AdilAry/Embed_System_Project/Software/Unsorted_Material/Embed_System_Project-main/Hardware/MISC/pcb back.jpeg

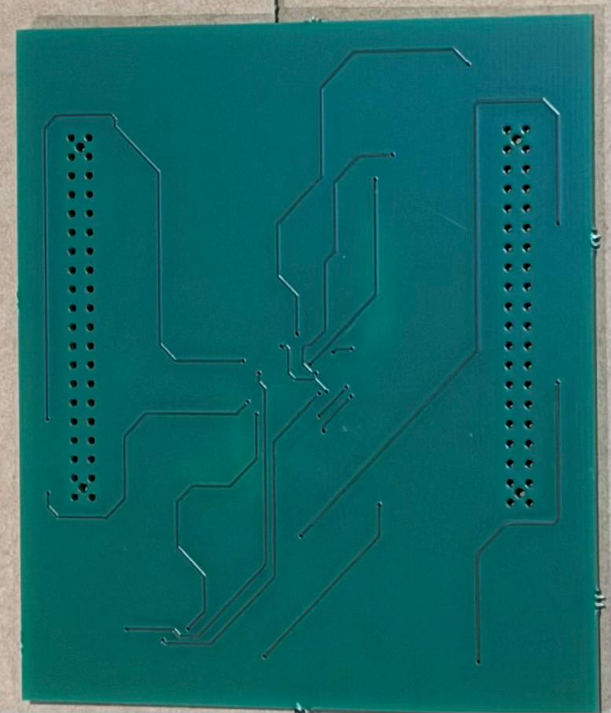
Software/Unsorted_Material/Embed_System_Project-main/Hardware/MISC/pcb back.jpeg
