AdilAry/Embed_System_Project/Software/Unsorted_Material/Embed_System_Project-main/Hardware/MISC/pcb front.jpeg

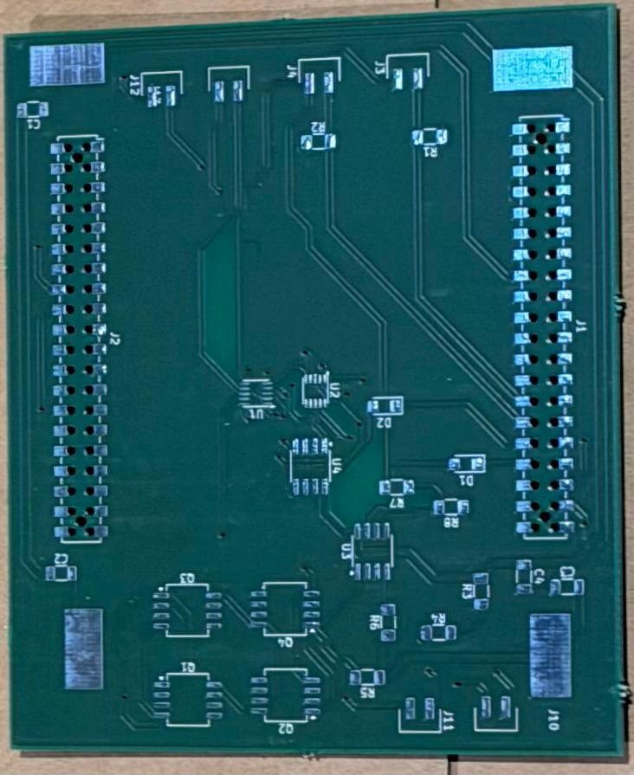
Software/Unsorted_Material/Embed_System_Project-main/Hardware/MISC/pcb front.jpeg
