AdilAry/Embed_System_Project/Software/Unsorted_Material/Embed_System_Project-main/Hardware/MISC/Info_Dump/BMS ICs.md

---
created: 2025.09.30 8:55 AM Tuesday
tags: red
---
https://www.ti.com/product-category/battery-management-ics/overview.html
