AdilAry/Embed_System_Project/Software/Unsorted_Material/Embed_System_Project-main/Hardware/MISC/Info_Dump/MOSFET.md

---
created: 2025.09.24 9:18 AM Wednesday
tags: red
---
https://www.youtube.com/results?search_query=mosfets+
https://www.mokoenergy.com/bms-mosfet/

https://diysolarforum.com/threads/bms-mosfets-explained.29318/
https://www.upnorthandpersonal.net/?page_id=112

https://www.aosmd.com/sites/default/files/res/application_notes/mosfets/MOS-013.pdf
