AdilAry/Embed_System_Project/Software/Unsorted_Material/Embed_System_Project-main/Hardware/2.LTspice/4.Diagram/Like_This_(example)/0.Explanations.md

Component_1 -> Analog signal processing.
Component_2 -> Transmitter.
Component_3 -> Powersupply.

---
### Diagram.

Transformer -> Power supply -> 
-> Analog signal processing -> Transmitter.
