AdilAry/Embed_System_Project/Software/Unsorted_Material/Embed_System_Project-main/Hardware/4.Documentation/English_Course.docx

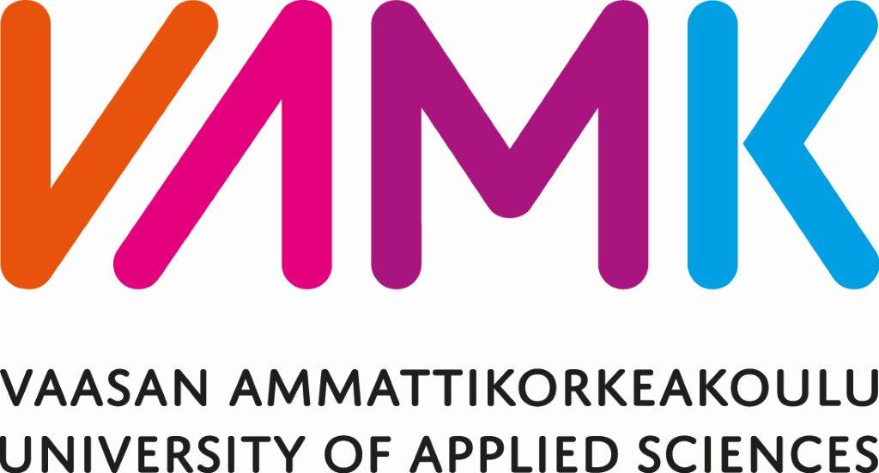
[picture p10: figure]
VAMK Vaasan ammattikorkeakoulu, University of Applied Sciences.

battery Management System

Progress report

Embedded Systems Project

2025

CONTENTS

# 1 Introduction

This report is focused on providing the team’s progress on making the Battery Management System project.

## 1.1 Battery Management System

Battery Management System, or BMS for short, is a system that, at its very basic, protects a battery or batteries from different electrical hazards like short circuits, cell overcharge, and overcurrent, as well as providing valuable information on the connected device; Voltage, current, and temperature measurements.

## 1.2 Progress

So far we have compiled a number of source for the research and learning purposes, as well as made many different drafts and partially implemented them in Ltspice. Unfortunatly, due to strict deadlines in place as per the time needed for the manufacturing and ordering of Printed Circuit Boards.

# 2 Project plans

## 2.1 Schematic and Printed Circuit Board

As mentioned before a strict schedule puts limitations on what the team can accomplish, instead focusing on finishing the simulations a hard decision to pivot straight into the designing the PCB was made.

## 2.2 Component choice

After the PCB is complete and is ready to be ordered, will be the time to order the component used to build the final project.
