AdilAry/Embed_System_Project/Software/Unsorted_Material/Embed_System_Project-main/Hardware/2.LTspice/4.Diagram/Like_This_(example)/Diagram_The_Transformer_breaks_the_PC_so_its_not_there.png

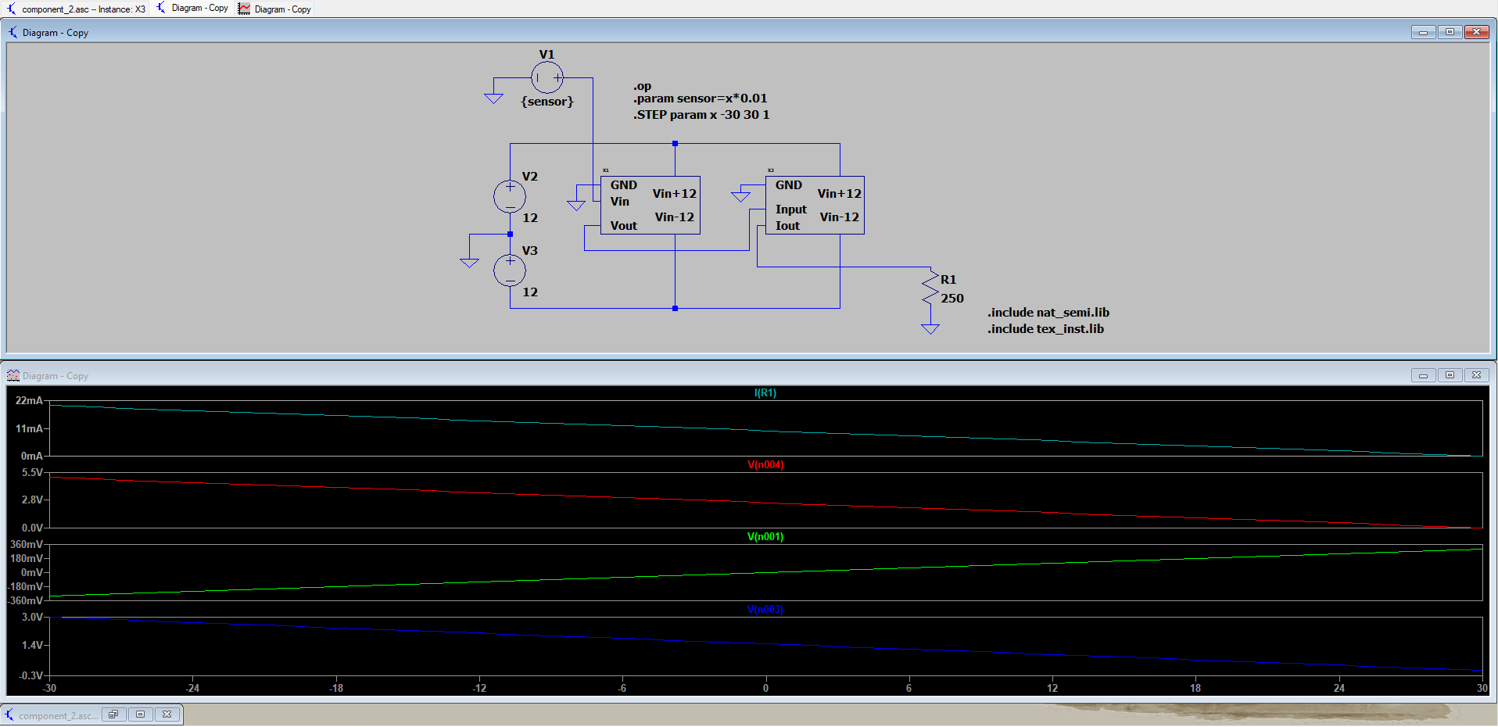
Software/Unsorted_Material/Embed_System_Project-main/Hardware/2.LTspice/4.Diagram/Like_This_(example)/Diagram_The_Transformer_breaks_the_PC_so_its_not_there.png
