AdilAry/Embed_System_Project/Software/Unsorted_Material/Embed_System_Project-main/Hardware/2.LTspice/4.Diagram/Like_This_(example)/Screenshot 2025-09-22 090422.png

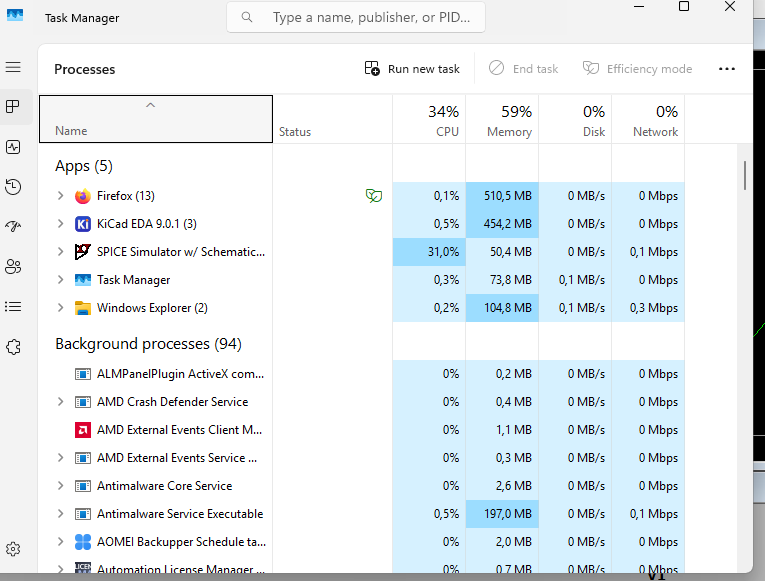
Software/Unsorted_Material/Embed_System_Project-main/Hardware/2.LTspice/4.Diagram/Like_This_(example)/Screenshot 2025-09-22 090422.png
