AdilAry/Embed_System_Project/Software/Presentation_Material/Communications_Documentation.odt

VAMK Vaasan ammattikorkeakoulu, University of Applied Sciences.

Communications

Documentation

Embedded Systems Programming 2025

CONTENTS

# Introduction

This document is aimed at providing all the necessary information and details regarding the BMS communications, for the purposes of making the Software team’s life easier.

The document will contain, the communication standard, protocol, used STM pins and what kind of data the software side should receive and how that data should be interpreted.

## Software introduction;

The software part overall can be seperated into three:

- On a board, to collect, communicate/send three data points(current, temperature and individual cell voltages of a battery) and also act upon those data points(drive the MOSFET switch, Control MUX adress line switches).

- On a computer, to visualize those three data points as a readable graph.

- On a database, to store a log of the mentioned three data points across a timeline.

## Communications choices;

The choice of a communications protocol fell into Modbus where the BMS will be the slave node and PC will function as the master node. The communication will be done through cable with the RS-485 standard.

# Specifications

## Board controll;

The board shouldn’t just collect and send the data, but also act upon.

PC0 – For charge control.

PC1 – For discharge control.

And the output from those into the MOSFET should be higher than 600 mV to ensure that their gates can open.

PC2, PC3 – For A0 and A1 line controll switches of the Multiplexers.

## Input from Board;

PA4 – Takes in voltage measurements of a single battery cell.

PB1 – Takes in current measurements.

PA0, PA1 – Taking in temperature measurements.

## Expected Behaviour;

Regularly switch between individual battery cells for voltage measurement via PC2 and PC3, whenever any single out of the four cells has a voltage measurement below 2.5V or above 3.65V initiate discharge.

Whenever any of the two thermistors records temperatures below -20 C or above 40 C initiate discharge.
