AdilAry/Embed_System_Project/Software/Unsorted_Material/Embed_System_Project-main/Hardware/3.Budgeting/BOM.xlsx

Mouser No. | Mfr. No. | Quantity
737-RS2BE-20-G-SMT | RS2BE-20-G-SMT | 2 | 2x20 conn
504-NRBE104J3435B2J | NRBE104J3435B2J | 2 |  | Thermistor
708-RNCE0805BTE10K0 | RNCE0805BTE10K0 | 6 | 10KO resistor
781-SI4116DY-E3 | SI4116DY-T1-E3 | 4 |  | NMOS
595-TMUX1204DQAR | TMUX1204DQAR | 2 | Multiplexer
78-MMSZ4683-HE3_A-08 | MMSZ4683-HE3_A-08 | 2 |  | Zener 3
437-8018700240002101 | 801-87-002-40-002101 | 2 | 1x2 conn female
80-C0805F104K1RAUTO | C0805F104K1RACAUTO | 2 |  | 100nF Capacitor
595-INA826AIDR | INA826AIDR | 2 | Instrumentation Amplifier
667-ERJ-UP6D1600V | ERJ-UP6D1600V | 1 |  | 160 Resistor
603-PU2512FKNP50R01L | PU2512FKNP50R001L | 1 | 1m Shunt
649-1012938090202ALF | 10129380-902002ALF | 2 |  | 1x2 conn male
