AdilAry/Embed_System_Project/Software/Unsorted_Material/Embed_System_Project-main/Hardware/3.Budgeting/Manufacturer.md

https://aisler.net/

Based in Germany, ~10 days delivery, Accepts KiCAD files.
