AdilAry/Embed_System_Project/Software/Unsorted_Material/Embed_System_Project-main/Hardware/4.Documentation/Soldering and manufacturer documentation.odt

Embedded System Project

Documentation

Parts : Manufacturer, delivered product, soldering

Manufacturer

Manufacturer part was a fun and decision making part of the project we looked into several manufacturers and while doing that we were given some criteria to select the manufacturer. Those criteria were, European manufacturer, do not pay shipping cost, price shouldn’t be too expensive. Well these gave us some hard time because most cheap manufacturers were from china and other Asian parts of the world, some European manufacturer do it for cheaper price but their shipping was too long , in the end we selected Aisler , they gave us the quote for 35€ for three PCB so we selected it .

Issues: the shipping took too long than we expected and we didn’t choose tracking so we got some post retransfer issues.

Delivered Product:

Delivery of the product was nice and clean, it was exactly what we expected but then we found out the traces we made was smaller for some components but that’s other part issues will be covered there.

Soldering.

This was my favorite part of this project, while soldering we were able to solder many components easily using the air gun using the hot air gun was pretty new and we had to learn some technics on how not to burn some components, when it came to some components like mosfets and the shunt resistor the traces were too small .

Issues: traces were too small for mosfets and the shunt resistor, burnt the temperature sensor.

Fix: we couldn’t do anything for the mosfets but we attached extra wires to the shunt resistor and made it work , for the burnt temperature sensor luckily we had 2 so we used the other one, so now we learnt a lesson to double check and be more careful to create traces which can be actually soldered to the components.
