AdilAry/Embed_System_Project/Software/Unsorted_Material/Embed_System_Project-main/Hardware/MISC/Problem_1/Explanations_Screenshot.png

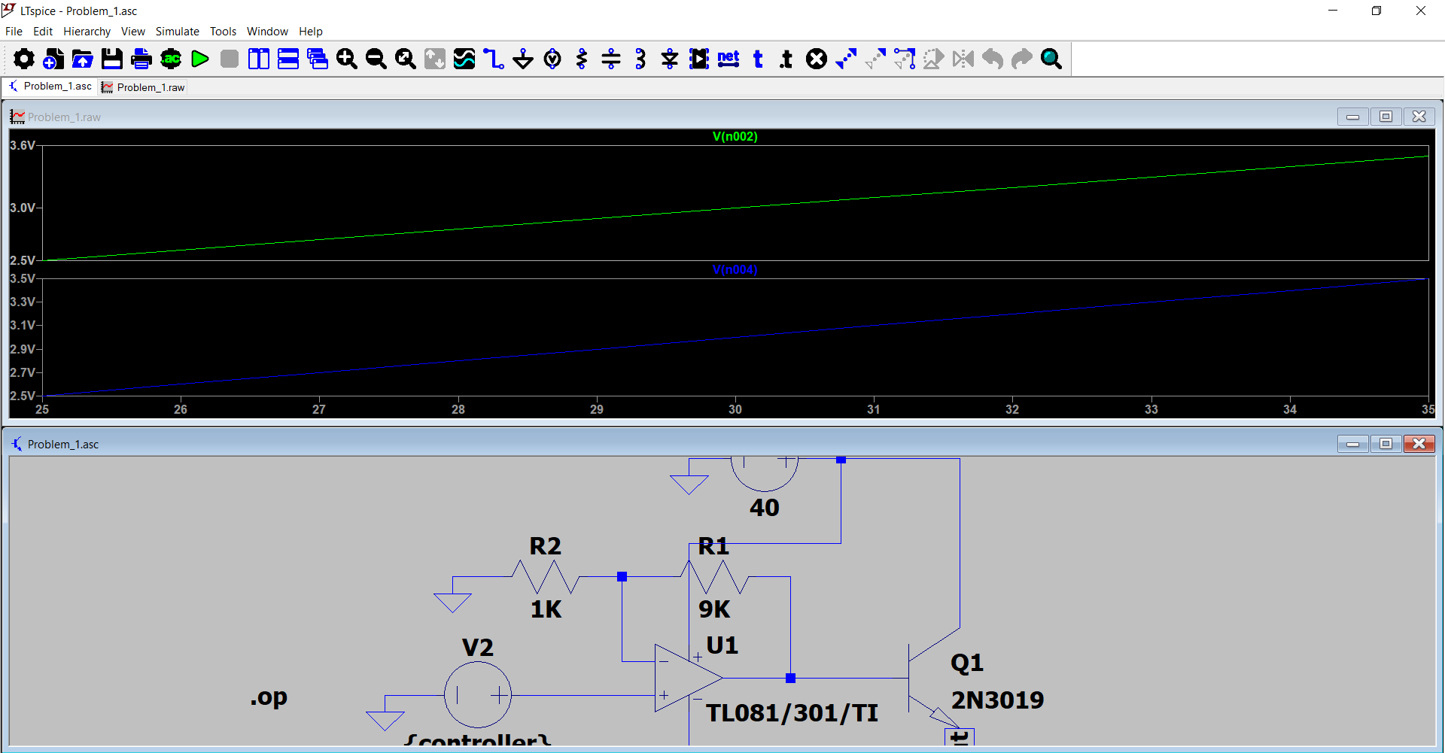
Software/Unsorted_Material/Embed_System_Project-main/Hardware/MISC/Problem_1/Explanations_Screenshot.png
