AdilAry/Embed_System_Project/Software/Unsorted_Material/Embed_System_Project-main/Hardware/MISC/Problem_1/Screenshot (424).png

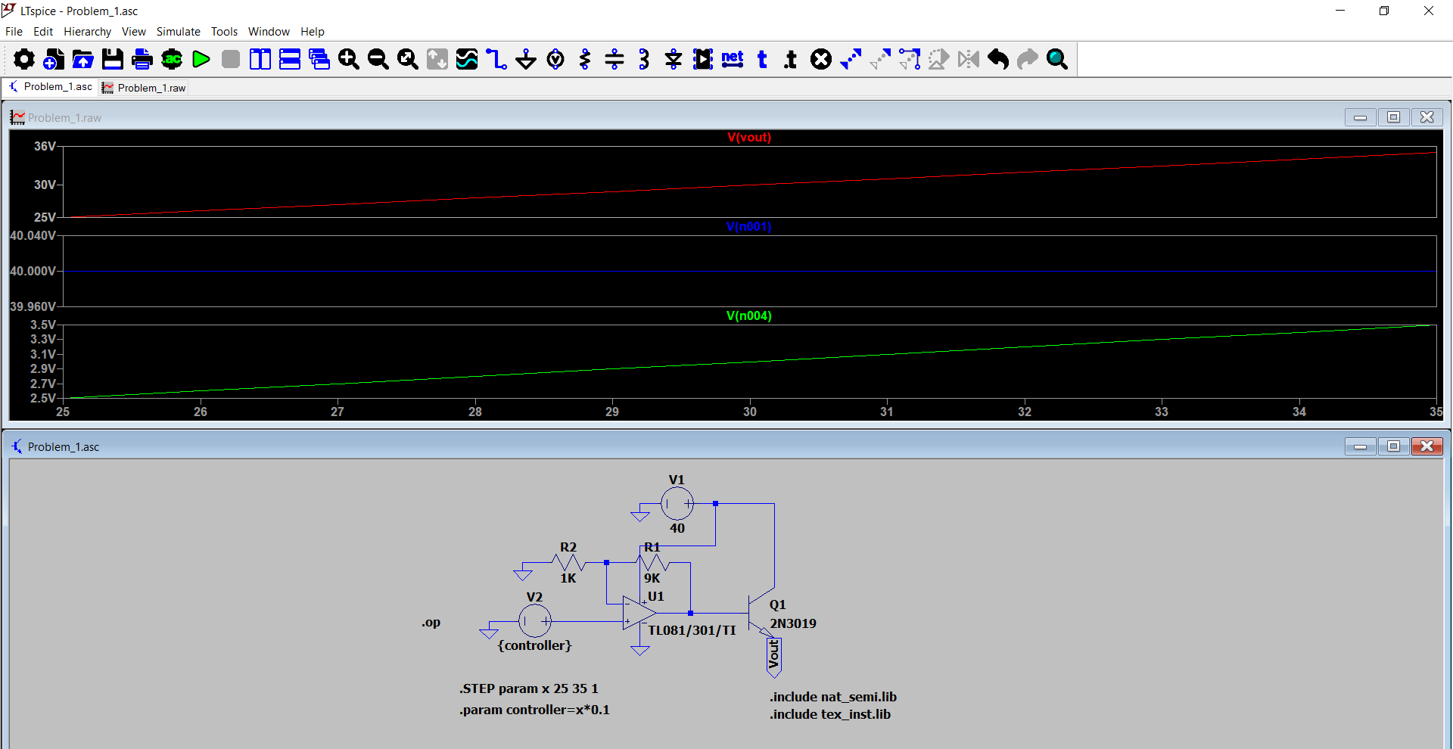
Software/Unsorted_Material/Embed_System_Project-main/Hardware/MISC/Problem_1/Screenshot (424).png
