AdilAry/Embed_System_Project/Software/Unsorted_Material/Embed_System_Project-main/Hardware/MISC/Problem_1/LTspice/Problem_1.asc

Q1: npn; 2N3019
R1: res; 9K
R2: res; 1K
U1: opamp2; TL081/301/TI
V1: voltage; 40
V2: voltage; {controller}
Named nets: 0, Vout
.STEP param x 25 35 1
.param controller=x*0.1
.op
.include nat_semi.lib
.include tex_inst.lib
