AdilAry/Embed_System_Project/Software/Unsorted_Material/Embed_System_Project-main/Hardware/2.LTspice/1.Swtich_Drafts/Draft.asc

D1: LED
D2: LED
M1: nmos
M2: nmos
R1: res
V1: voltage
V2: voltage
V3: voltage
V4: voltage
V5: voltage; {c_control}
V6: voltage; {d_control}
Named nets: Vout, 0
.include nat_semi.lib
.include tex_inst.lib
