AdilAry/Embed_System_Project/Software/Unsorted_Material/Embed_System_Project-main/Hardware/2.LTspice/2.Current_Measurement_Drafts/Draft.asc

D1: zener
R1: res
R2: res
R3: res
U1: opamp2
V1: voltage; 3
V2: voltage; 3
V3: voltage; 3
V4: voltage; 3
Named nets: 0, Vout, Imaginary_Fuse
.include nat_semi.lib
.include tex_inst.lib
