AdilAry/Embed_System_Project/Software/Unsorted_Material/Embed_System_Project-main/Hardware/2.LTspice/3.Voltage_Measurement_Drafts/Draft.asc

D2: zener
R1: res
R2: res
U1: opamp2
V1: voltage; {x}
V5: voltage; 15
Named nets: Vout, 0
.include nat_semi.lib
.include tex_inst.lib
