AdilAry/Embed_System_Project/Software/Unsorted_Material/Embed_System_Project-main/Hardware/2.LTspice/3.Voltage_Measurement_Drafts/Draft_full.asc

R1: res
R2: res
R3: res
R4: res
R5: res
R6: res
R7: res
R8: res
U1: opamp2
U2: opamp2
U3: opamp2
U4: opamp2
V1: voltage; 1
V2: voltage; 2
V3: voltage; 3
V4: voltage; 4
V5: voltage; 15
Named nets: 0, Vout
.include nat_semi.lib
.include tex_inst.lib
