AdilAry/Embed_System_Project/Software/Unsorted_Material/Embed_System_Project-main/Hardware/MISC/Problem_1/Component_3.asc

C1: cap; 600µ
C2: cap; 100n
C3: cap; 600µ
C4: cap; 100n
C5: cap; 100n
C6: cap; 1000µ
C7: cap; 100n
C8: cap; 1000µ
D1: diode; 1N4148
D2: diode; 1N4148
D3: diode; 1N4148
D4: diode; 1N4148
L1: ind2; 3000
L2: ind2; 32
L3: ind2; 3000
L4: ind2; 32
R1: res; 1
R2: res; 1
R3: res; 470
R4: res; 4042
R5: res; 470
R6: res; 4042
U1: LM317
U2: LM337
V1: voltage; SINE(0 230 50 0 0 0 1e6)
Named nets: Vout-, Vout+, GND
.include nat_semi.lib
.include tex_inst.lib
K1 L1 L2 1
K2 L3 L4 1
