AdilAry/Embed_System_Project/Software/Unsorted_Material/Embed_System_Project-main/Hardware/2.LTspice/4.Diagram/Like_This_(example)/Component_1.asc

R2: res; 10K
R3: res; 256.4
R4: res; 10K
R5: res; 10K
R6: res; 50K
R7: res; 50K
U1: opamp2; TL071/301/TI
U2: opamp2; TL071/301/TI
U3: opamp2; TL071/301/TI
Named nets: Vin-12, Vin+12, GND, Vout, Vin
.include nat_semi.lib
.include tex_inst.lib
