AdilAry/Embed_System_Project/Software/Unsorted_Material/Embed_System_Project-main/Hardware/2.LTspice/4.Diagram/Like_This_(example)/Component_2.asc

C1: cap; 100n
Q1: npn; BC547B
R1: res; 150
R3: res; 100
R4: res; 150K
R5: res; 150K
R6: res; 150K
R7: res; 150K
U1: opamp2; LM741/NS
Named nets: Iout, Vin+12, Vin-12, Input, GND
.include nat_semi.lib
.include tex_inst.lib
