AdilAry/Embed_System_Project/Software/Unsorted_Material/Embed_System_Project-main/Hardware/2.LTspice/4.Diagram/Like_This_(example)/Diagram - Copy.asc

R1: res; 250
V1: voltage; {sensor}
V2: voltage; 12
V3: voltage; 12
X1: Component_1
X3: Component_2
Named nets: 0
.include nat_semi.lib
.include tex_inst.lib
.STEP param x -30 30 1
.op
.param sensor=x*0.01
