AdilAry/Embed_System_Project/Software/Unsorted_Material/Embed_System_Project-main/Hardware/2.LTspice/4.Diagram/Like_This_(example)/Diagram_with_Transformer.asc

V1: voltage; {x}
X1: Component_1
X2: Component_3
X3: Component_2
Named nets: 0
.include nat_semi.lib
.include tex_inst.lib
.tran 0 200m 0 1m
.STEP param x -0.3 0.3 0.01
