AdilAry/Embed_System_Project/Software/Unsorted_Material/Embed_System_Project-main/Hardware/MISC/Problem_1/LTspice/Experimenting.asc

U1: opamp2
V2: voltage; 12
V3: voltage; 12
V4: voltage; {x}
Named nets: VCC, VEE, 0, out
.op
.include nat_semi.lib
.param
