AdilAry/Embed_System_Project/Software/Unsorted_Material/Embed_System_Project-main/Hardware/1.KiCAD/KiCAD.kicad_pcb

## KiCad design Software/Unsorted_Material/Embed_System_Project-main/Hardware/1.KiCAD/KiCAD.kicad_pcb (2025-10-10)

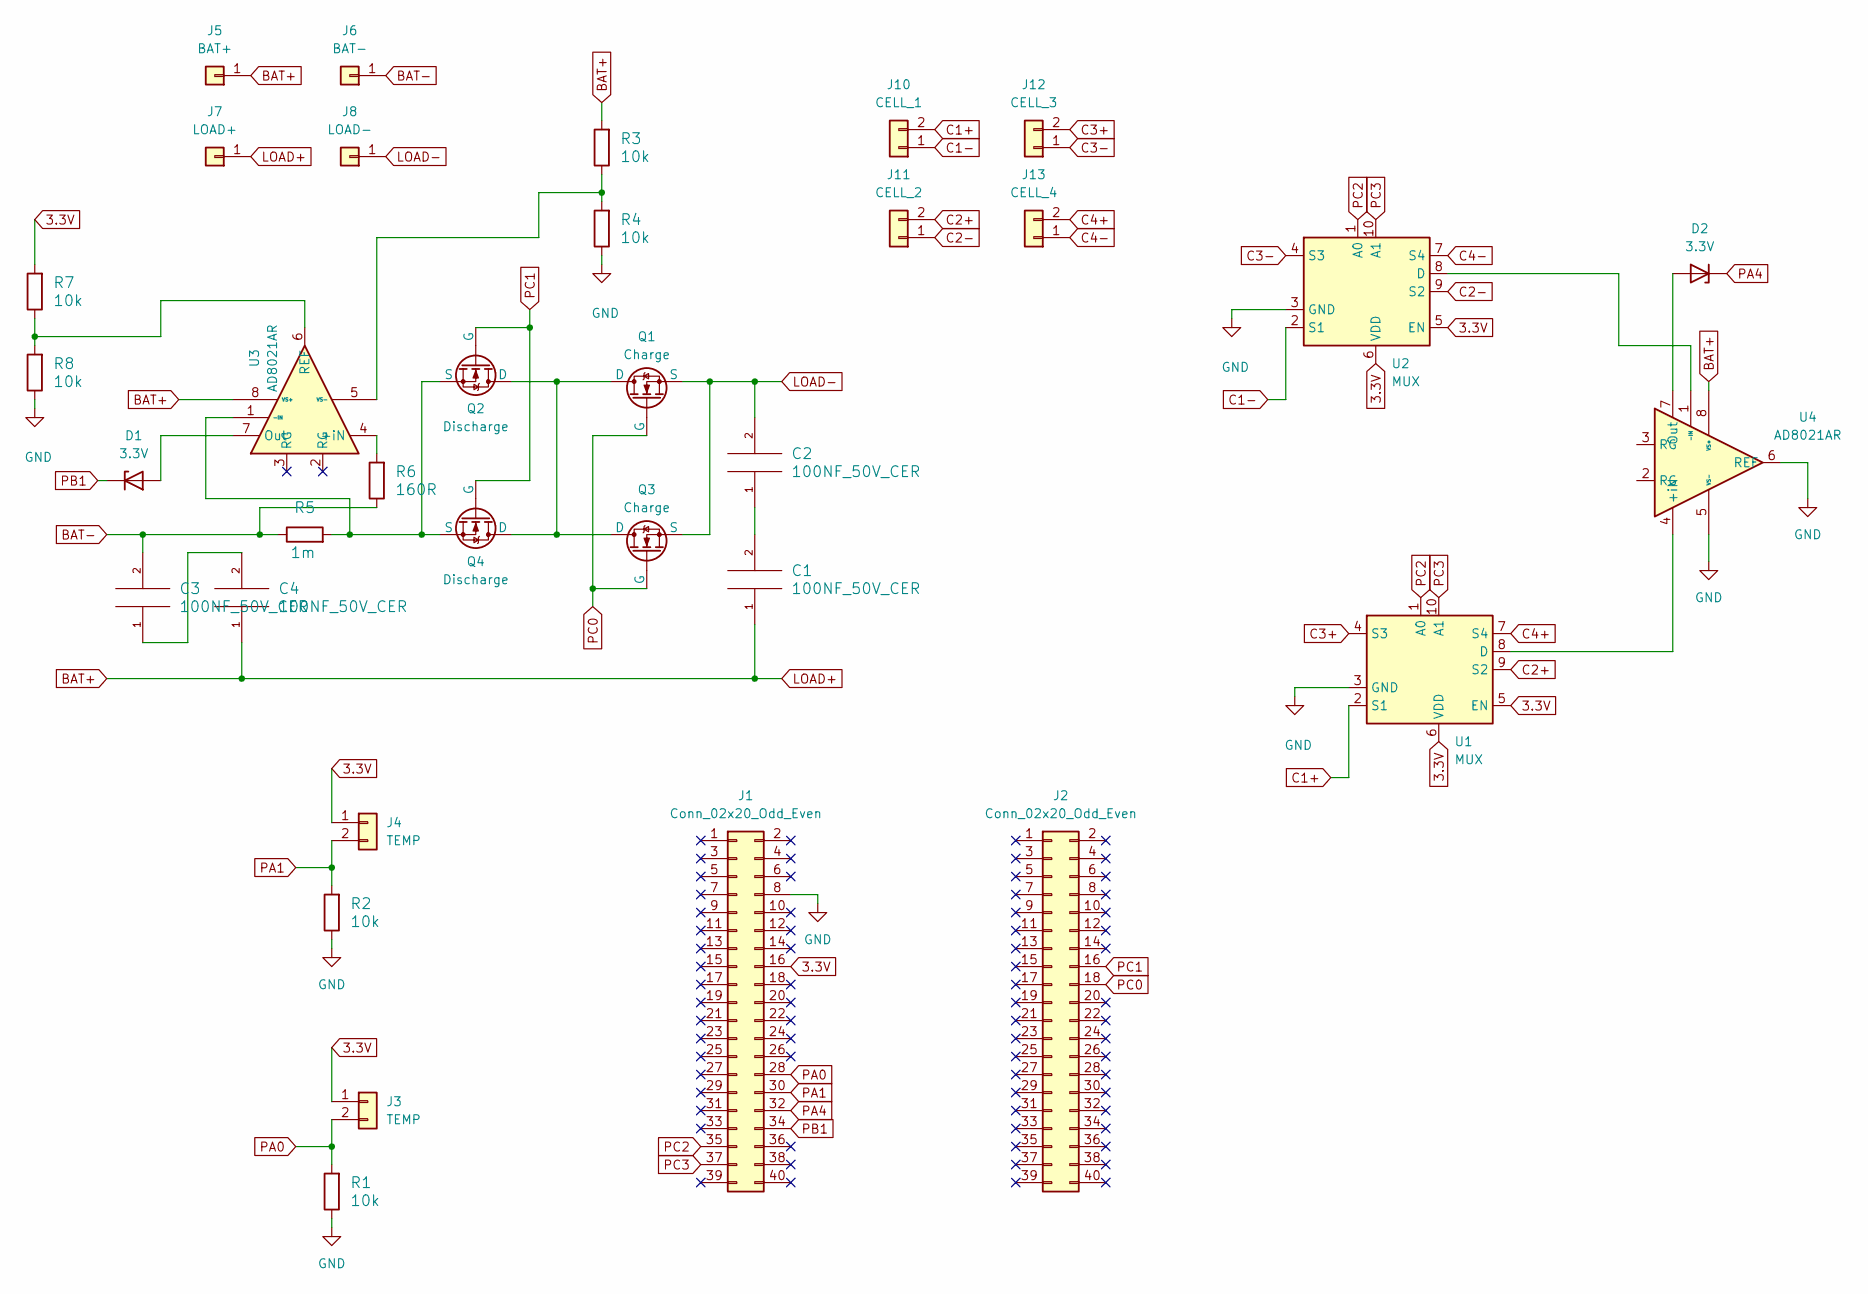
[picture p15: schematic KiCAD.kicad_sch]

Parts:
C1, C2, C3, C4: 100NF_50V_CER; C1206; Tolerance +-10%
D1, D2: 3.3V; D_SMF
J1, J2: Conn_02x20_Odd_Even; Samtec_HLE-120-02-xxx-DV-BE-LC_2x20_P2.54mm_Horizontal
J3, J4: TEMP; PinHeader_1x02_P2.54mm_Vertical_SMD_Pin1Left
J5: BAT+; SolderWirePad_1x01_SMD_5x10mm
J6: BAT-; SolderWirePad_1x01_SMD_5x10mm
J7: LOAD+; SolderWirePad_1x01_SMD_5x10mm
J8: LOAD-; SolderWirePad_1x01_SMD_5x10mm
J10: CELL_1; PinHeader_1x02_P2.54mm_Vertical_SMD_Pin1Left
J11: CELL_2; PinHeader_1x02_P2.54mm_Vertical_SMD_Pin1Left
J12: CELL_3; PinHeader_1x02_P2.54mm_Vertical_SMD_Pin1Left
J13: CELL_4; PinHeader_1x02_P2.54mm_Vertical_SMD_Pin1Left
Q1, Q3: Charge; SOIC-8_5.3x6.2mm_P1.27mm
Q2, Q4: Discharge; SOIC-8_5.3x6.2mm_P1.27mm
R1, R2, R3, R4, R7, R8: 10k; 1206; Tolerance +-5%
R5: 1m; 1206; Tolerance +-5%
R6: 160R; 1206; Tolerance +-5%
U1, U2: MUX; TSSOP-10_3x3mm_P0.5mm
U3, U4: AD8021AR; SOIC-8_3.9x4.9mm_P1.27mm

Connections:
3.3V: J1.16, J3.1, J4.1, R7.2, U1.5 (EN), U1.6 (VDD), U2.5 (EN), U2.6 (VDD)
BAT+: C1.1, C4.1, J5.1, J7.1, R3.2, U3.8 (VS+), U4.8 (VS+)
BAT-: C3.2, J6.1, R5.1, R6.1
C1+: J10.2, U1.2 (S1)
C1-: J10.1, U2.2 (S1)
C2+: J11.2, U1.9 (S2)
C2-: J11.1, U2.9 (S2)
C3+: J12.2, U1.4 (S3)
C3-: J12.1, U2.4 (S3)
C4+: J13.2, U1.7 (S4)
C4-: J13.1, U2.7 (S4)
GND: J1.8, R1.1, R2.1, R4.1, R8.1, U1.3 (GND), U2.3 (GND), U4.5 (VS-), U4.6 (REF)
LOAD-: C2.2, J8.1, Q1.1 (S), Q3.1 (S)
unnamed: C1.2, C2.1
unnamed: C3.1, C4.2
unnamed: D1.2 (A), U3.7 (Out)
unnamed: D2.2 (A), U4.7 (Out)
unnamed: Q1.8 (D), Q2.8 (D), Q3.8 (D), Q4.8 (D)
unnamed: Q2.1 (S), Q4.1 (S), R5.2, U3.1 (-IN)
unnamed: U1.8 (D), U4.4 (+iN)
unnamed: U2.8 (D), U4.1 (-IN)
unnamed: R6.2, U3.4 (+iN)
unnamed: R7.1, R8.2, U3.6 (REF)
unnamed: R3.1, R4.2, U3.5 (VS-)
PA0: J1.28, J3.2, R1.2
PA1: J1.30, J4.2, R2.2
PA4: D2.1 (K), J1.32
PB1: D1.1 (K), J1.34
PC0: J2.18, Q1.4 (G), Q3.4 (G)
PC1: J2.16, Q2.4 (G), Q4.4 (G)
PC2: J1.35, U1.1 (A0), U2.1 (A0)
PC3: J1.37, U1.10 (A1), U2.10 (A1)

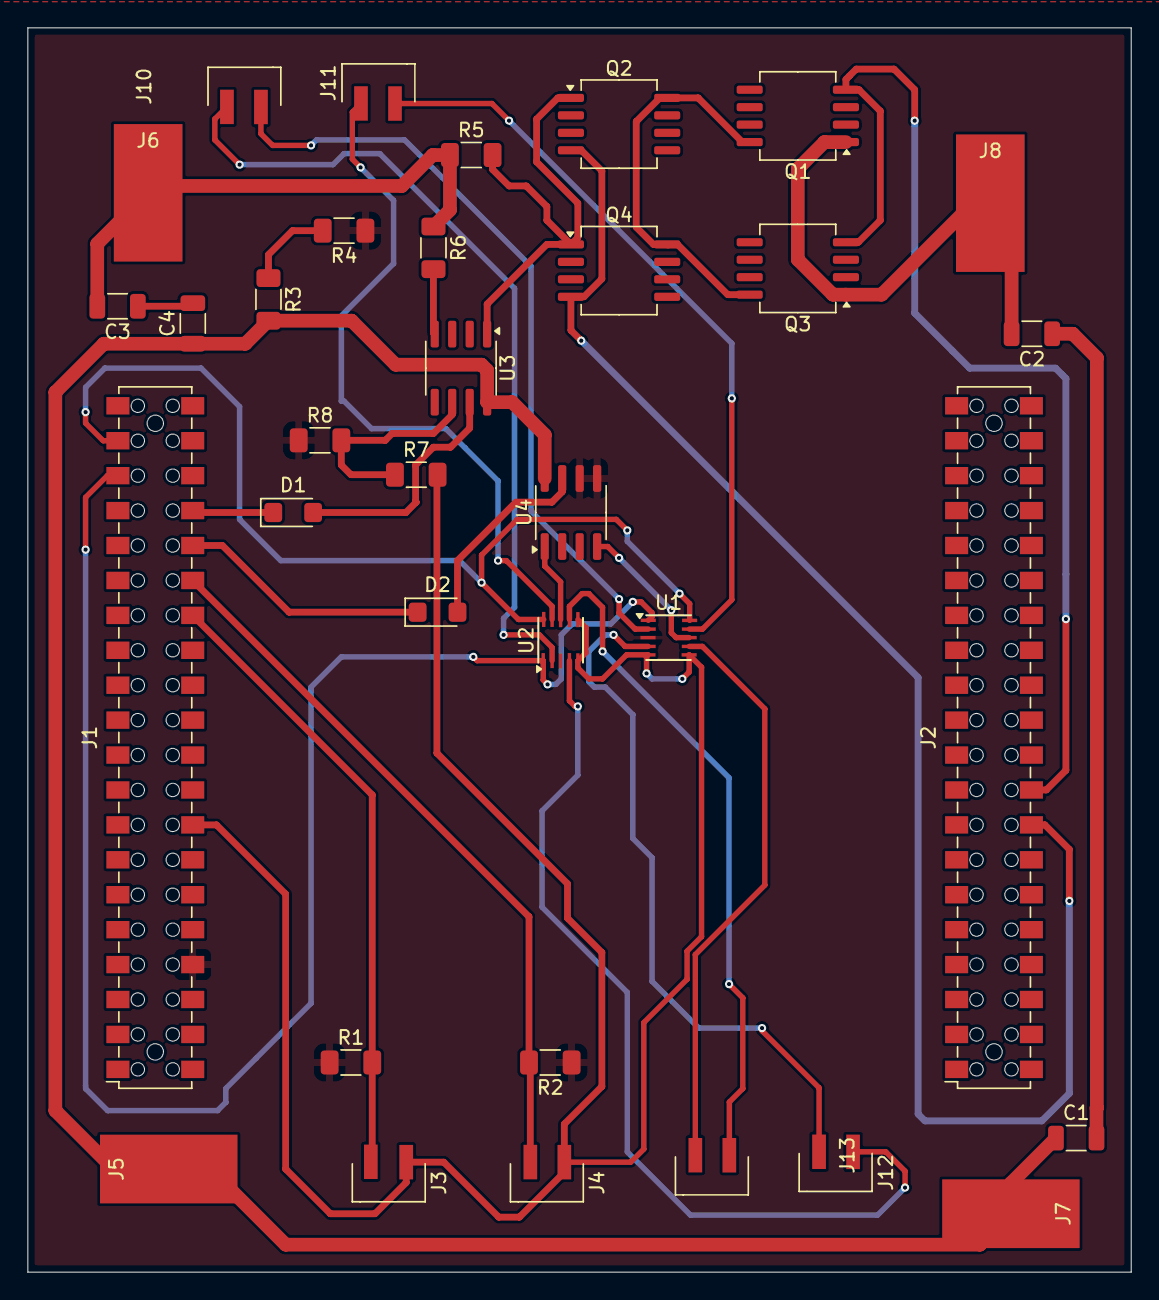
[picture p16: board KiCAD.kicad_pcb from above]

Board: 2 copper layers, 80.2 x 90.5 mm, 34 parts (0 on the bottom side), 32 nets.
