AdilAry/Embed_System_Project/Software/Unsorted_Material/New folder/PPS/RotoPD.kicad_pcb

## KiCad design Software/Unsorted_Material/New folder/PPS/RotoPD.kicad_pcb (2025-12-18)

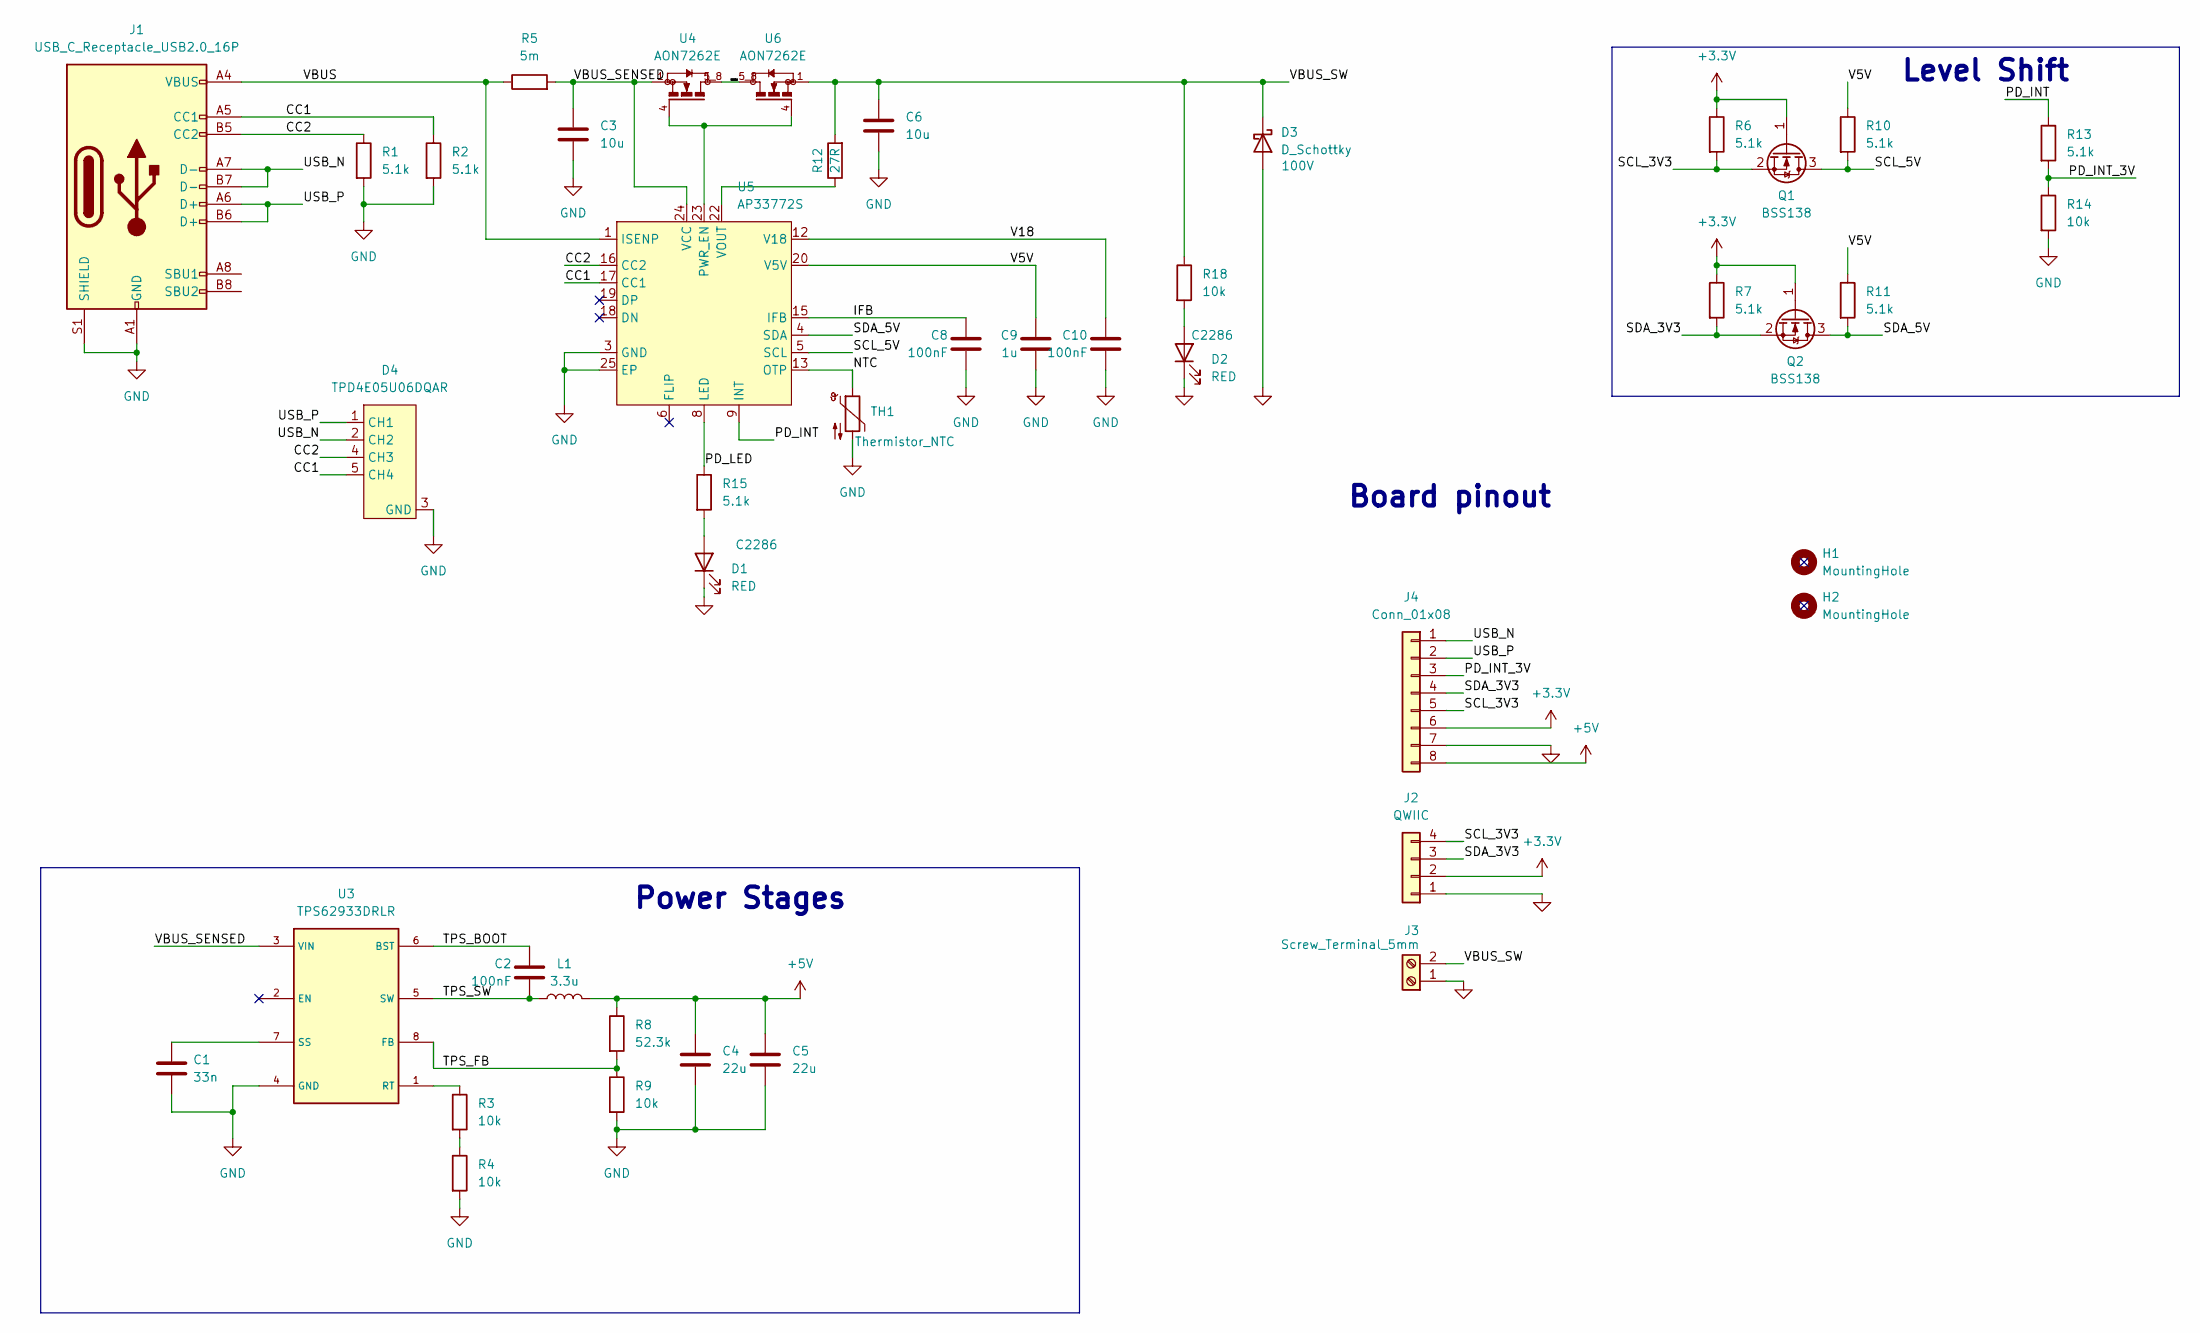
[picture p17: schematic RotoPD.kicad_sch]

Parts:
C1: 33n; C_0603_1608Metric; LCSC C21117
C2, C8, C10: 100nF; C_0402_1005Metric; LCSC C1525
C3, C6: 10u; C_1206_3216Metric; LCSC C513774
C4, C5: 22u; C_0805_2012Metric; LCSC C45783
C9: 1u; C_0603_1608Metric; LCSC C15849
D1, D2: RED; LED_0603_1608Metric; LCSC C2286
D3: D_Schottky; D_SMA; Voltage 100V; LCSC C14996
D4: TPD4E05U06DQAR; SON50P100X255X50-10N
H1, H2: MountingHole; MountingHole_2.7mm_M2.5_DIN965_Pad_TopBottom
J1: USB_C_Receptacle_USB2.0_16P; USB_C_GSwitch
J2: QWIIC; JST_SH_SM04B-SRSS-TB_1x04-1MP_P1.00mm_Horizontal; LCSC C160404
J3: Screw_Terminal_5mm; TerminalBlock_Phoenix_MKDS-1,5-2_1x02_P5.00mm_Horizontal
J4: Conn_01x08; PinHeader_1x08_P2.54mm_Vertical
L1: 3.3u; L_Bourns_SRP7028A_7.3x6.6mm
Q1: BSS138; SOT-323_SC-70
Q2: BSS138; SOT-323_SC-70; JLCPCB Rotation Offset 180
R1, R2, R6, R7, R10, R11, R13, R15: 5.1k; R_0402_1005Metric; LCSC C25905
R3, R4, R9, R14, R18: 10k; R_0402_1005Metric; LCSC C25744
R5: 5m; R_0805_2012Metric; Part # PA0805FRE470R005L; LCSC C728267
R8: 52.3k; R_0402_1005Metric; LCSC C103091
R12: 27R; R_0402_1005Metric; LCSC C138021
TH1: Thermistor_NTC; R_0402_1005Metric; LCSC C77131
U3: TPS62933DRLR; SOT583
U4, U6: AON7262E; DFN-8(3.3x3.3)
U5: AP33772S; QFN-24-1EP_4x4mm_P0.5mm_EP2.6x2.6mm; LCSC C9900152998

Connections:
+3.3V: J2.2, J4.6, Q1.1 (G), Q2.1 (G), R6.1, R7.1
+5V: C4.1, C5.1, J4.8, L1.2, R8.1
/CC1: D4.5 (CH4), D4.6, J1.A5 (CC1), R2.1, U5.17 (CC1)
/CC2: D4.4 (CH3), D4.7, J1.B5 (CC2), R1.1, U5.16 (CC2)
/IFB: C8.1, U5.15 (IFB)
/NMOS: U4.5_8, U6.5_8
/NTC: TH1.1, U5.13 (OTP)
/PD_INT: R13.1, U5.9 (INT)
/PD_INT_3V: J4.3, R13.2, R14.1
/PD_LED: R15.1, U5.8 (LED)
/SCL_3V3: J2.4, J4.5, Q1.2 (S), R6.2
/SCL_5V: Q1.3 (D), R10.2, U5.5 (SCL)
/SDA_3V3: J2.3, J4.4, Q2.2 (S), R7.2
/SDA_5V: Q2.3 (D), R11.2, U5.4 (SDA)
/TPS_BOOT: C2.1, U3.6 (BST)
/TPS_FB: R8.2, R9.1, U3.8 (FB)
/TPS_SW: C2.2, L1.1, U3.5 (SW)
/USB_N: D4.2 (CH2), D4.9, J1.A7 (D-), J1.B7 (D-), J4.1
/USB_P: D4.1 (CH1), D4.10, J1.A6 (D+), J1.B6 (D+), J4.2
/V5V: C9.1, R10.1, R11.1, U5.20 (V5V)
/V18: C10.1, U5.12 (V18)
/VBUS: J1.A4 (VBUS), J1.A9 (VBUS), J1.B4 (VBUS), J1.B9 (VBUS), R5.1, U5.1 (ISENP)
/VBUS_SENSED: C3.1, R5.2, U3.3 (VIN), U4.1, U4.2, U4.3, U5.24 (VCC)
/VBUS_SW: C6.1, D3.1 (K), J3.2, R12.2, R18.1, U6.1, U6.2, U6.3
GND: C1.2, C3.2, C4.2, C5.2, C6.2, C8.2, C9.2, C10.2, D1.1 (K), D2.1 (K), D3.2 (A), D4.3 (GND), D4.8 (GND), J1.A1 (GND), J1.A12 (GND), J1.B1 (GND), J1.B12 (GND), J1.S1 (SHIELD), J2.1, J3.1, J4.7, R1.2, R2.2, R4.2, R9.2, R14.2, TH1.2, U3.4 (GND), U5.3 (GND), U5.25 (EP)
unnamed: D1.2 (A), R15.2
unnamed: D2.2 (A), R18.2
unnamed: R3.2, R4.1
unnamed: R3.1, U3.1 (RT)
unnamed: C1.1, U3.7 (SS)
unnamed: U5.2 (NC), U5.7 (NC), U5.10 (NC), U5.11 (NC), U5.14 (NC), U5.21 (NC)
unnamed: U4.4, U5.23 (PWR_EN), U6.4
unnamed: R12.1, U5.22 (VOUT)

Notes on the sheet:
Power Stages
Level Shift
Board pinout

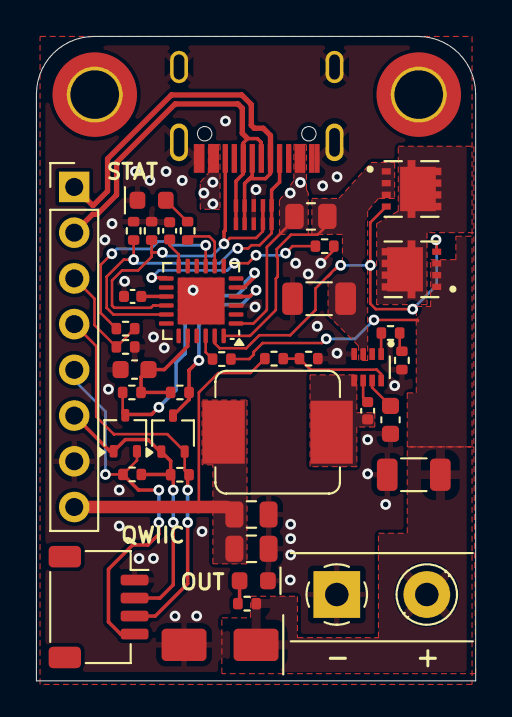
[picture p18: board RotoPD.kicad_pcb from above]

Board: 2 copper layers, 24.4 x 35.8 mm, 43 parts (0 on the bottom side), 33 nets.
