AdilAry/Embed_System_Project/(commit log)

2025-09-06 Knowledge base added
    [KiCAD.kicad_pcb, KiCAD.kicad_sch]
2025-09-22 README changes
    [KiCAD.kicad_pcb, KiCAD.kicad_sch]
2025-09-26 Drafts commited, KiCAD libraries moved, Exercise 1 moved
    [KiCAD.kicad_pcb, KiCAD.kicad_sch]
2025-10-09 Schematic drafts, BOM drafts, Datasheets added
    [BOM.xlsx, KiCAD.kicad_pcb, KiCAD.kicad_sch]
2025-10-09 BOM finished
    [BOM.xlsx, KiCAD.kicad_pcb, KiCAD.kicad_sch]
2025-10-10 Schematic and PCB V1 done
    [BOM.xlsx, KiCAD.kicad_pcb, KiCAD.kicad_sch]
2025-11-12 pcb pictures added to the presentation
2025-11-15 PCB test report file added
2025-11-16 Communication document
    [KiCAD.kicad_pcb, KiCAD.kicad_sch]
2025-11-18 Manufacturer and soldering documentation
2025-11-19 Add files via upload
    Manufacturer and soldering documentation
2025-12-16 sort out
    [BOM.csv, BOM.xlsx, KiCAD.kicad_pcb, KiCAD.kicad_sch, RotoPD.kicad_pcb, RotoPD.kicad_sch, positions.csv]
